csn495/source_one/SourceOne-v4/photos/source_one_v4_2.JPG

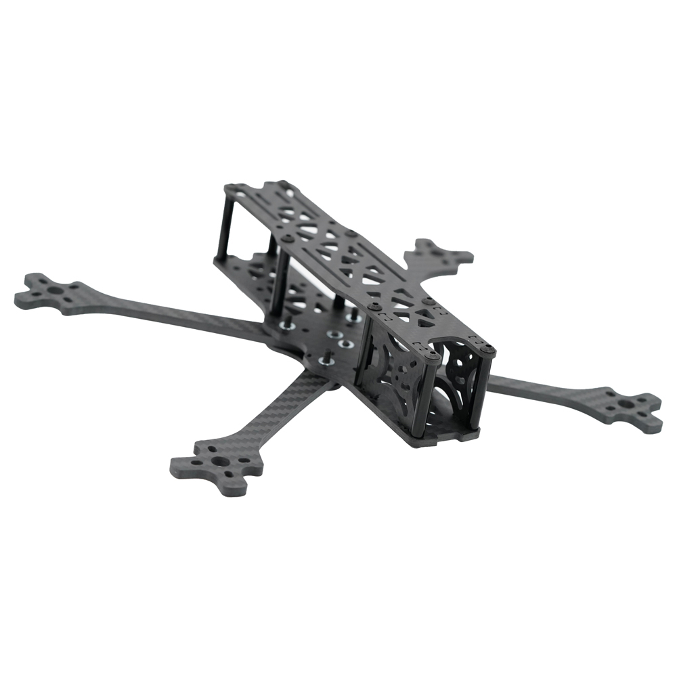
SourceOne-v4/photos/source_one_v4_2.JPG
