csn495/source_one/SourceOne-v4/photos/source_one_v4_10.jpg

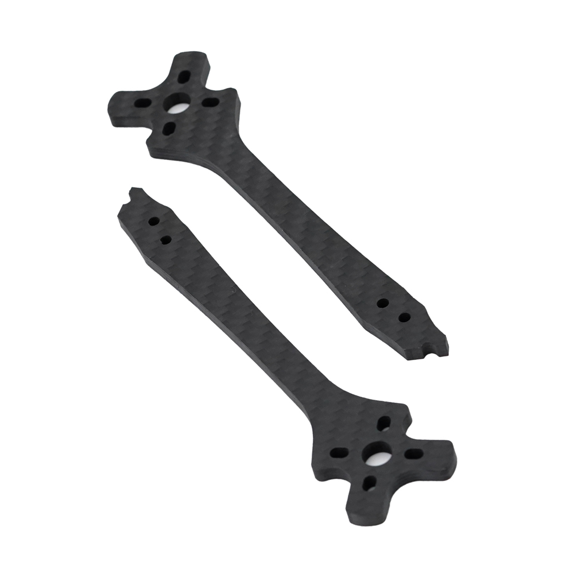
SourceOne-v4/photos/source_one_v4_10.jpg
