csn495/source_one/SourceOne-v4/SO_v4_top_plate_2mm.dxf

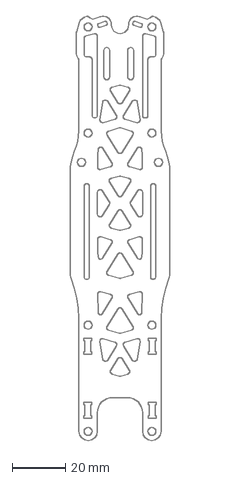
[picture p12: CAD file, 2022-02-15]
SourceOne-v4/SO_v4_top_plate_2mm.dxf
37.5 x 159.8 mm
