csn495/source_one/SourceOne-v4/SO_v4_5inch_arm_4mm_4x.dxf

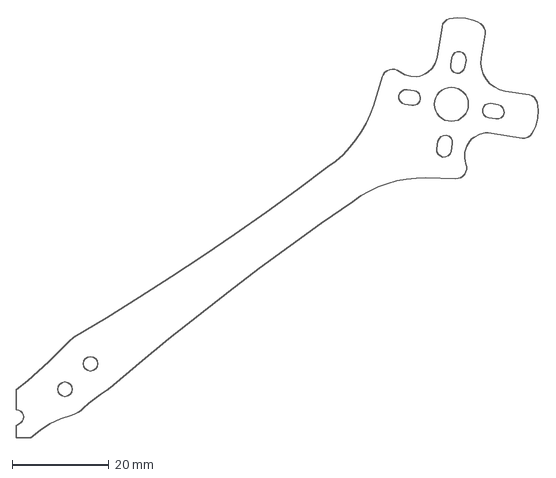
[picture p13: CAD file, 2022-02-15]
SourceOne-v4/SO_v4_5inch_arm_4mm_4x.dxf
107.9 x 86.9 mm
