csn495/source_one/SourceOne-v4/SO_v4_battery_pad_top.dxf

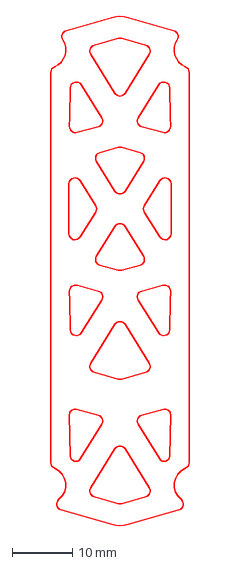
[picture p14: CAD file, 2022-02-15]
SourceOne-v4/SO_v4_battery_pad_top.dxf
23.0 x 84.7 mm
