csn495/source_one/SourceOne-v4/SO_v4_7inch_arm_6mm_back_2x.dxf

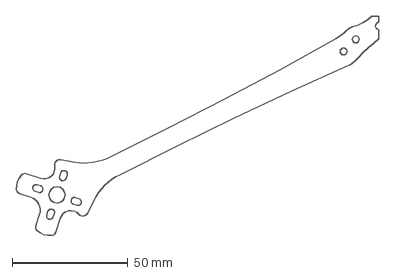
[picture p15: CAD file, 2022-02-15]
SourceOne-v4/SO_v4_7inch_arm_6mm_back_2x.dxf
156.6 x 94.8 mm
