csn495/source_one/SourceOne-v4/SO_v4_bottom_plate_3mm.dxf

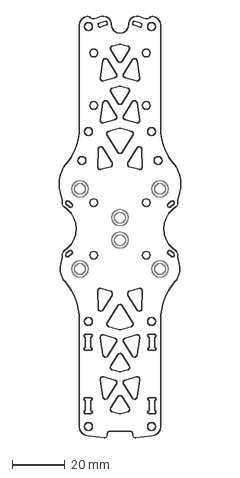
[picture p16: CAD file, 2022-02-15]
SourceOne-v4/SO_v4_bottom_plate_3mm.dxf
47.7 x 160.6 mm
