csn495/source_one/SourceOne-v4/SO_v4.STEP

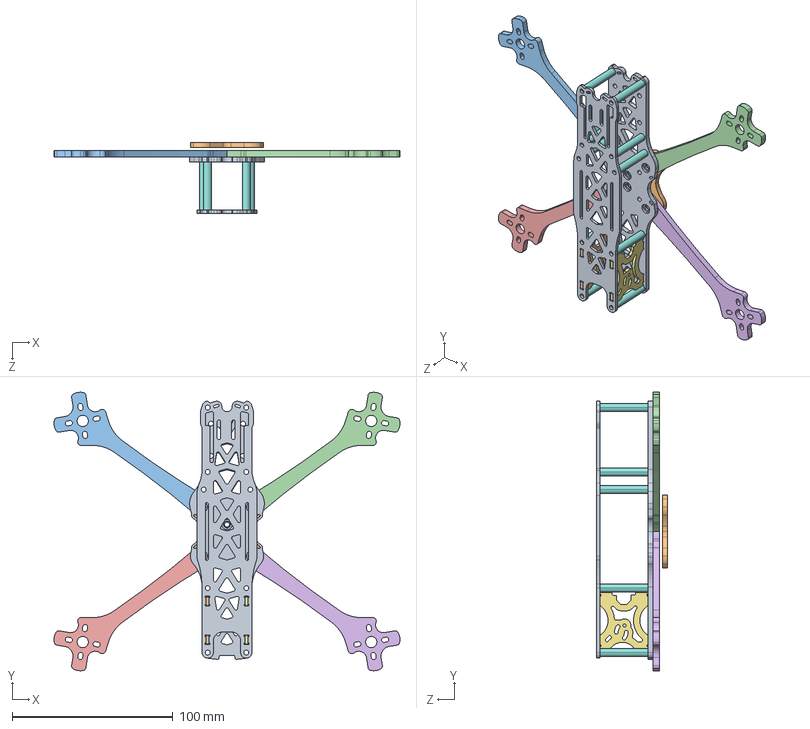
[picture p17: CAD file, 2022-02-15]
SourceOne-v4/SO_v4.STEP
215.1 x 173.2 x 44.0 mm
So1-V4-2020-DEC-07-3D1
So1-V4-2020-DEC-07-3D2
So1-V4-2020-DEC-07-3D3
So1-V4-2020-DEC-07-3D4
So1-V4-2020-DEC-07-3D5
So1-V4-2020-DEC-07-3D6
So1-V4-2020-DEC-07-3D7
So1-V4-2020-DEC-07-3D8
So1-V4-2020-DEC-07-3D9
So1-V4-2020-DEC-07-3D10
So1-V4-2020-DEC-07-3D11
So1-V4-2020-DEC-07-3D12
So1-V4-2020-DEC-07-3D13
So1-V4-2020-DEC-07-3D14
So1-V4-2020-DEC-07-3D15
So1-V4-2020-DEC-07-3D16
So1-V4-2020-DEC-07-3D17
So1-V4-2020-DEC-07-3D18
So1-V4-2020-DEC-07-3D19
