csn495/source_one/SourceOne-v4/SO_v4_7inch_arm_6mm_front_2x.dxf

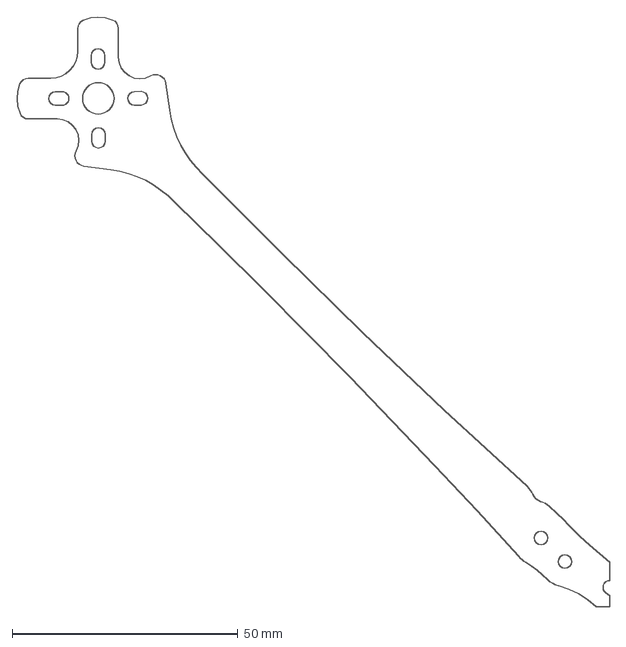
[picture p18: CAD file, 2022-02-15]
SourceOne-v4/SO_v4_7inch_arm_6mm_front_2x.dxf
131.6 x 130.9 mm
