csn495/source_one/SourceOne-v4/SO_v4_cam_plate_2mm_2x.dxf

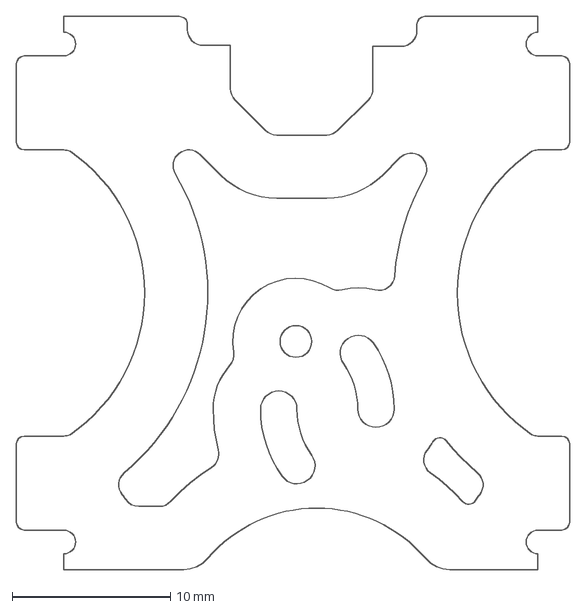
[picture p19: CAD file, 2022-02-15]
SourceOne-v4/SO_v4_cam_plate_2mm_2x.dxf
35.0 x 35.0 mm
