csn495/source_one/SourceOne-v4/SO_v4_center_plate_3mm.dxf

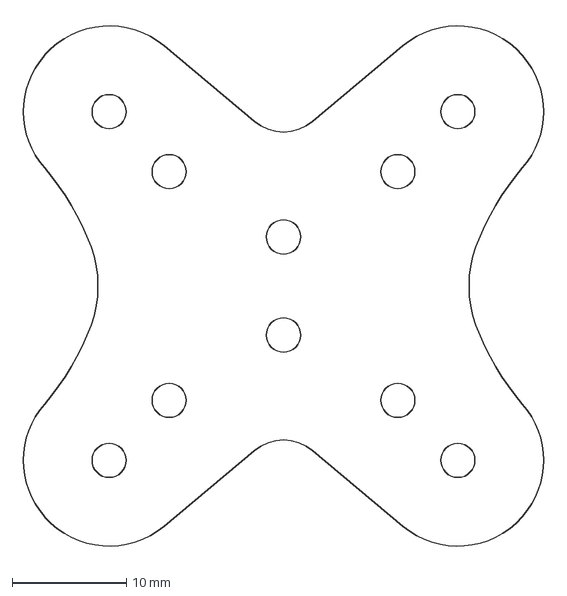
[picture p20: CAD file, 2022-02-15]
SourceOne-v4/SO_v4_center_plate_3mm.dxf
46.7 x 47.2 mm
