csn495/source_one/SourceOne-v3/3D Print - GoPro Session Mount/Session-Mount.stl

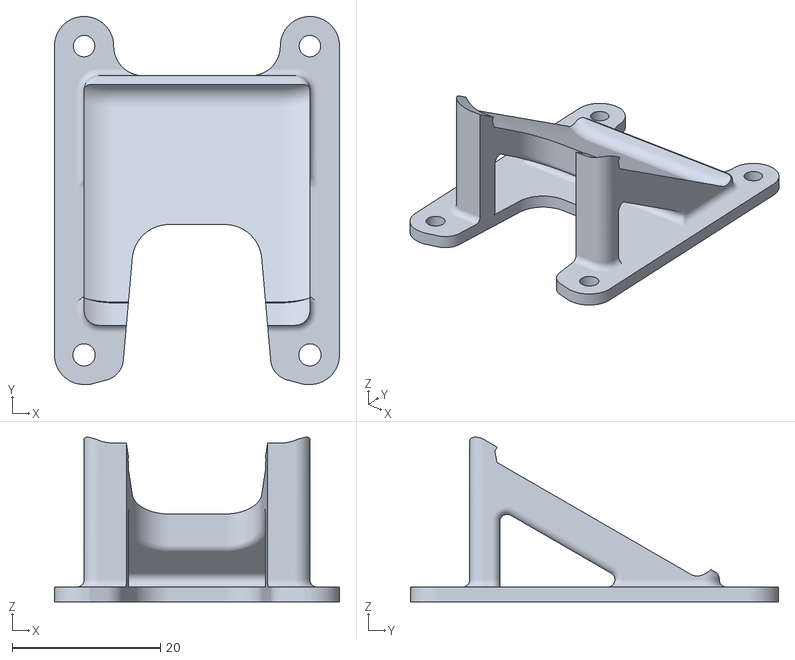
[picture p21: CAD file, 2022-02-15, an earlier design]
SourceOne-v3/3D Print - GoPro Session Mount/Session-Mount.stl
38.5 x 49.7 x 22.2
