csn495/source_one/SourceOne-v3/3D Print - Immortal-T Mount/IT-Mount-01.stl

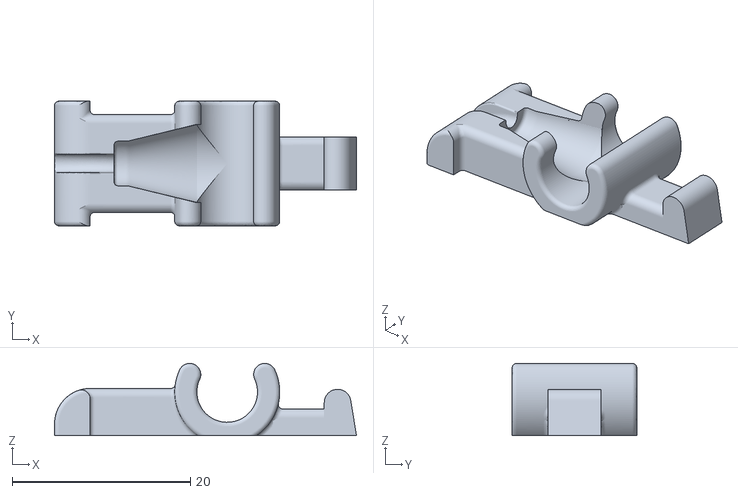
[picture p22: CAD file, 2022-02-15, an earlier design]
SourceOne-v3/3D Print - Immortal-T Mount/IT-Mount-01.stl
33.9 x 14.0 x 8.12
