csn495/source_one/SourceOne-v3/3D Print - VTX Mount/VTX mount - VTX.stl

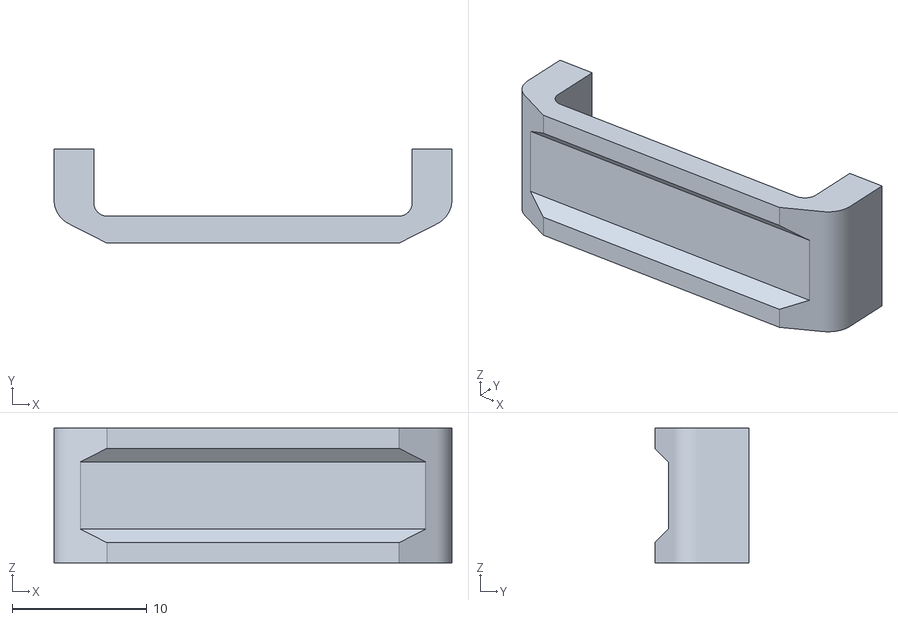
[picture p23: CAD file, 2022-02-15, an earlier design]
SourceOne-v3/3D Print - VTX Mount/VTX mount - VTX.stl
29.5 x 7.00 x 10.00
