csn495/source_one/SourceOne-v3/accessories/SO_v3_battery_pad_top.dxf

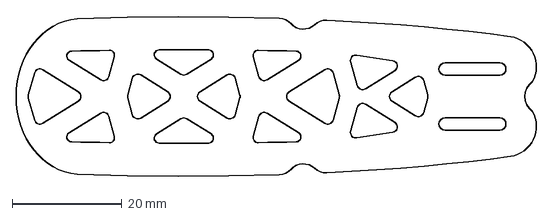
[picture p24: CAD file, 2022-02-15, an earlier design]
SourceOne-v3/accessories/SO_v3_battery_pad_top.dxf
95.0 x 29.2 mm
