csn495/source_one/SourceOne-v3/SO_v3_7inch_dead_cat_arm_6mm_4x.dxf

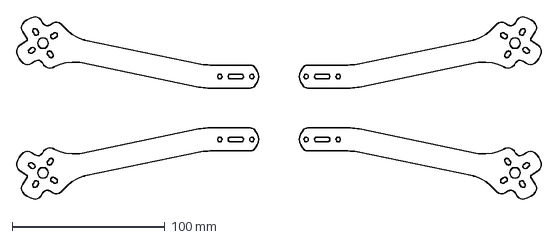
[picture p25: CAD file, 2022-02-15, an earlier design]
SourceOne-v3/SO_v3_7inch_dead_cat_arm_6mm_4x.dxf
343.8 x 119.9 mm
