csn495/source_one/SourceOne-v3/3D Print - VTX Mount/VTX mount - SMA.stl

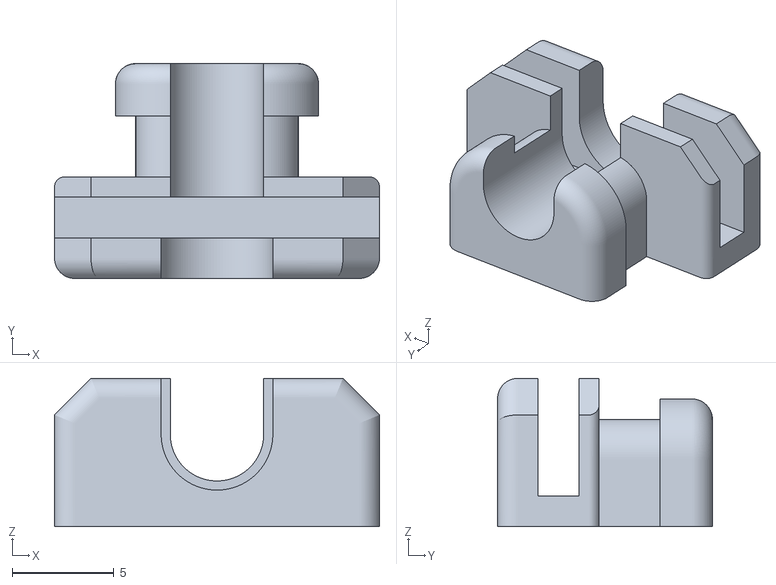
[picture p26: CAD file, 2022-02-15, an earlier design]
SourceOne-v3/3D Print - VTX Mount/VTX mount - SMA.stl
16.0 x 10.6 x 7.30
