csn495/source_one/SourceOne-v3/accessories/VTX Mount 45degree_Dipole_Antenna_L-Mount.stl

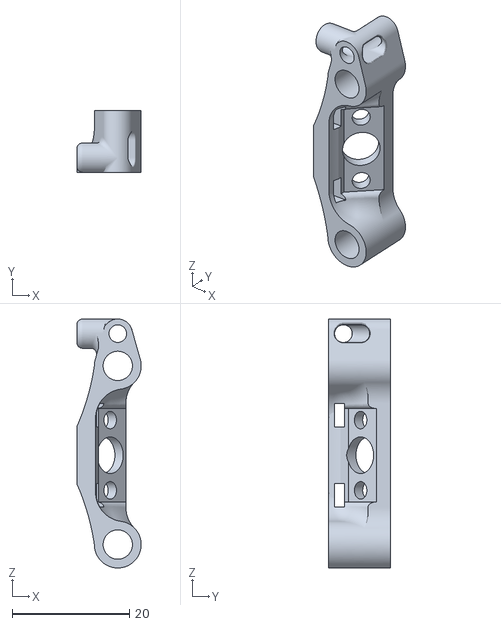
[picture p27: CAD file, 2022-02-15, an earlier design]
SourceOne-v3/accessories/VTX Mount 45degree_Dipole_Antenna_L-Mount.stl
11.0 x 10.5 x 42.5
