csn495/source_one/SourceOne-v3/SO_v3_cam_plate_2mm_2x.dxf

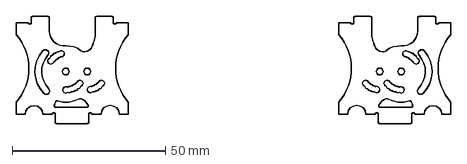
[picture p28: CAD file, 2022-02-15, an earlier design]
SourceOne-v3/SO_v3_cam_plate_2mm_2x.dxf
142.0 x 35.0 mm
