csn495/source_one/SourceOne-v3/accessories/Wolf_Outline.dxf

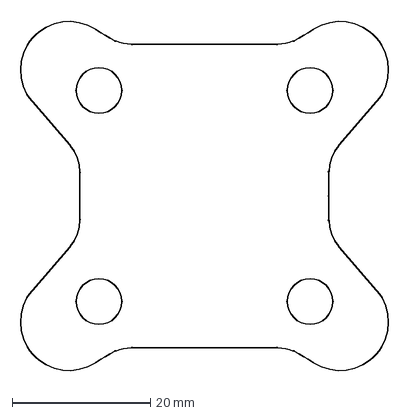
[picture p29: CAD file, 2022-02-15, an earlier design]
SourceOne-v3/accessories/Wolf_Outline.dxf
54.3 x 52.0 mm
