csn495/source_one/(list of files, cad)

Other CAD files:
SourceOne-v3/SO_v03.f3d
SourceOne-v3/SO_v3_5inch_arm_4mm_4x.dxf
SourceOne-v3/SO_v3_7inch_arm_6mm_4x.dxf
SourceOne-v3/SO_v3_bottom_plate_3mm.dxf
SourceOne-v3/SO_v3_center_plate_3mm.dxf
SourceOne-v3/SO_v3_top_plate_2mm.dxf
SourceOne-v3/accessories/Battery bottom mount Back.stl
SourceOne-v3/accessories/Battery bottom mount Front.stl
SourceOne-v3/accessories/DiversityRX-SMA - VTX Mount.stl
SourceOne-v3/accessories/HGLRC GPS Mount.stl
SourceOne-v3/accessories/SourceOne Session Mount 25ø NO-ND.stl
SourceOne-v3/accessories/TBS Immortal T Mount.stl
SourceOne-v3/accessories/TBS Immortal T Mount_without_support.stl
SourceOne-v3/accessories/VTX Mount 45degree.stl
SourceOne-v3/accessories/VTX Mount Vertical.stl
SourceOne-v4/SO_v4.f3d
SourceOne-v4/SO_v4.igs
