csn495/source_one/SourceOne-v3/photos/wallpaper/s1.pdf

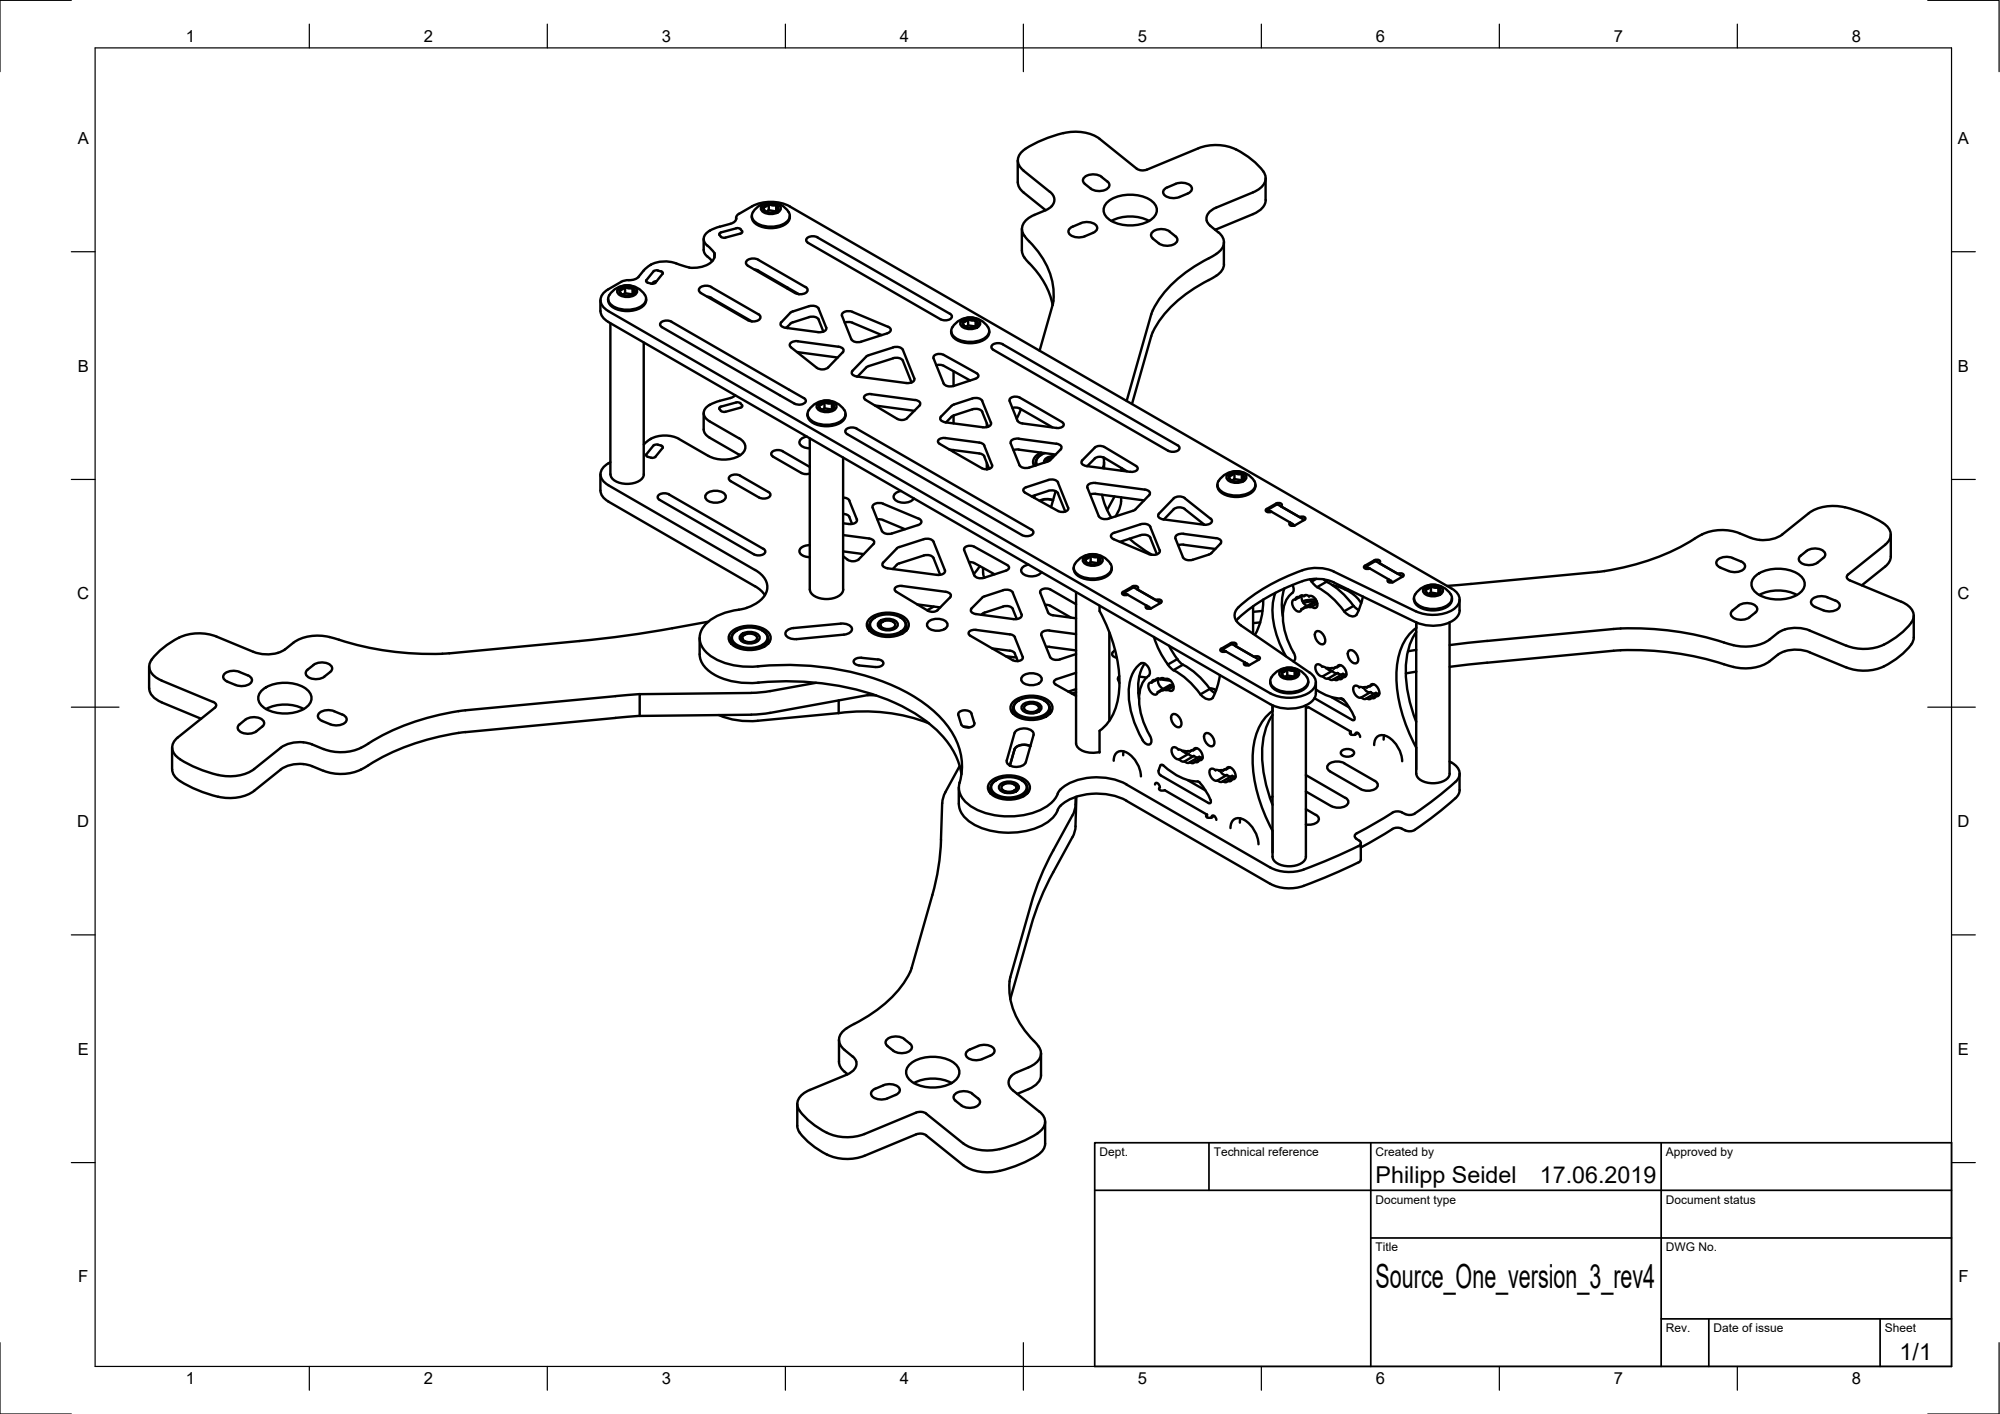
[picture p30: page 1]

Dept. | Technical reference | Created by Philipp Seidel 17.06.2019 | Approved by

Document type | Document status

Title Source_One_version_3_rev4 | DWG No.

Rev. | Date of issue | Sheet 1/1
