csn495/source_one/(commit log)

2022-02-15 Moved V4 files into V4 folder
    [Battery bottom mount Back.stl, Battery bottom mount Front.stl, DiversityRX-SMA - VTX Mount.stl, HGLRC GPS Mount.stl, IT-Mount-01.stl, SO_v3_battery_pad_top.dxf, SO_v4.STEP, SO_v4.f3d]
2022-02-15 Added v3 folder and contents from tbs release
    [Battery bottom mount Back.stl, Battery bottom mount Front.stl, DiversityRX-SMA - VTX Mount.stl, HGLRC GPS Mount.stl, IT-Mount-01.stl, SO_v03.f3d, SO_v3_5inch_arm_4mm_4x.dxf, SO_v3_7inch_arm_6mm_4x.dxf]
